Leon-AW/Saugroboter/README.md

# Fachuebergreifendes Projekt: Saugroboter

Unser Projekt verfolgt das Ziel einen automatisierten Staubsauger zu bauen und zu programmieren, welcher selbstständig den Raumboden von Staub oder anderen Partikeln befreit. Durch den Eigenbau soll die Wartung und Reparatur und somit die Instandhaltung erleichtert werden.

## Authoren

1. Leila Oppermann
2. Ala Al-Khazzan
3. Marc Zimmermann
4. Leon Wagner

## Hinweise

### Bedienungsanleitung

Der Saugroboter wird über den weißen Wippschalter auf der Oberseite ein- und ausgeschaltet.
Hinweise vor Inbetriebnahme:
1. Vor dem Einschalten sollte darauf geachtet werden, dass keine Sicherheitsrisiken wie Stufen, Hänge oder Nässe für den Saugroboter zugänglich sind. Ist der Saugroboter in einem trockenen ebenen Raum platziert, so kann er eingeschaltet werden. Der Saugroboter reinigt solange den Boden, bis er ausgeschaltet wird oder der Akkustand niedrig ist. In diesem Fall schaltet er sich selbstständig aus.
2. Vor jedem Einschalten sollte der Schmutzauffangbehälter an der Oberseite des Gehäuses entnommen, geprüft und bei Bedarf geleert werden.

Der Akku wird über die Akkuladestation aufgeladen. Die Akkuladestation wird über normalen Haushaltsstrom 230V betrieben. Sobald es nötig ist, den Akku aufzuladen, leuchtet die rote Kontroll-LED an der Oberseite des Gehäuses. Solange der Saugroboter eingeschaltet ist, leuchtet die grüne Kontroll-LED an der Oberseite des Gehäuses.

Sollte der Saugroboter nicht wie erwartet funktionieren, so können die weiteren Kontroll-Leuchten Auskunft über das Problem geben. Siehe hierzu den Abschnitt "Wartung".

### Wartung

LED Color Code:
- Rot außen an: Akkustand niedrig.
- Grün außen an: Gerät eingeschaltet und mit ausreichend Strom versorgt.
- Grün außen blinkt schnell: Spannung zu niedrig, Akku und Verbindungen prüfen.
- Weiß innen an: Ventilator korrekt angeschlossen.
- Blau innen an: Ventilator Spannung korrekt.
- Gelb innen an: Spannung an der Batterie korrekt.

Der Saugroboter kann ohne Werkzeug geöffnet werden. Elektronik-affine NutzerInnen können anhand der Kontroll-LEDs viele häufige Fehler ausfindig machen und beheben. Alle Bauteile bis auf das Gehäuse können privat unter 30€ nachgekauft werden.
