Leon-AW/Saugroboter/Dokumentation/01-Lastenheft/Lastenheft_Gruppe1.pdf

Lastenheft
Saugroboter

© HTW Berlin

# Lastenheft im

# fachübergreifenden Projekt

## Saugroboter

Teammitglieder: | Leila Oppermann,
| Ala Al-Khazzan,
| Leon Wagner,
| Marc Zimmermann
Professor: | Dr.-Ing. Christian Müller
Produkt: | Saugroboter
Ort, Datum: | Berlin, 26.04.2022

© HTW Berlin | Seite I

### Inhaltsverzeichnis

Tabellenverzeichnis | II
Abbildungsverzeichnis | II

© HTW Berlin | Seite II

### Tabellenverzeichnis

### Abbildungsverzeichnis

© HTW Berlin | Seite 1

### 1 Einleitung

Heutzutage sind Smart Home Geräte, Smartphones und vieles mehr nicht mehr aus unserem Alltag wegzudenken. Der Mikroprozessor nimmt eine dominante Rolle in fast jedem Gerät ein, so ist er auch das Herzstück eines Saugroboters. Zu jedem modernen Haushalt gehört heutzutage auch ein kleiner Helfer, welcher den Raum automatisiert von Staub befreien kann und genau das gilt es hier zu entwickeln.

### 2 Ausgangssituation

Momentan sind Saugroboter teuer und nur für wohlhabende Menschen finanzierbar. Größere Firmen arbeiten täglich daran mit Ihrem Saugroboter den Markt zu dominieren. Dabei geht die Individualisierbarkeit des Saugroboters verloren und der Innenraum und dessen Funktionalität wird unübersichtlich.

### 3 Zielsetzung

Das Ziel des automatisierten Staubsaugers ist es, selbstständig den Raumboden von Staub oder anderen Partikeln zu befreien. Durch den Eigenbau sollen die Wartung und Reparatur und somit die Instandhaltung erleichtert werden. Damit richtet sich das Design des Roboters nach dem aktuell viel diskutierten „Right to Repair“. Des Weiteren stehen die Erarbeitung und Weitergabe von Wissen im Vordergrund. Die Sensorik und die Algorithmen des Saugroboters können von nachfolgenden Gruppen späterer Semester ausgebaut werden. So steht der HTW ein weiteres erweiterbares fachübergreifendes Projekt zur Verfügung. Auch die Entwicklung einer App und Ausstattung mit einem WiFi Modul wäre in der Zukunft denkbar.

### 4 Anforderungen

### 4.1 Funktionale Anforderungen

Alle Anforderungen werden hier mit hoher Priorität betrachtet.

Tabelle 1: Funktionale Anforderungen

Nr. | Gruppe | Beschreibung
FA 1 | Allgemein
FA-1.1 | | Der Saugroboter muss erkennen können, wenn der Ein- und Ausschaltknopf betätigt wird und darauf reagieren.
FA-1.2 | | Bei Erkennung des Anschaltzustandes soll die LED mit der je-weiligen Farbe leuchten.
FA-1.3 | | Der Saugroboter soll über einen Ardunio-Mikrocontroller ge-steuert werden.
FA-1.4 | | Als Energiequelle des Arduinos soll eine Batterie oder ein Akku verwendet werden.
FA 2 | Hinderniserken- nung
FA-2.1 | Die Software soll ermöglichen Hindernisse zu umfahren.
FA-2.2 | Es soll einen Bumpsensor geben, um Hindernisse zu registrie-ren.
FA 3 | Bewegung
FA-3.1 | Die Räder sollen einen Richtungswechsel durchführen können.
FA-3.2 | Der Antrieb der Räder soll über einen Servomotor erzielt wer-den.
FA 4 | Saugmechanismus
FA-4.1 | Zum Auffangen der Schmutzpartikel muss ein Staubbehälter verwendet werden.
FA-4.2 | Ein Ventilator soll die Luft einsaugen.
FA-4.3 | Ein Luftfilter soll die eingesogene Luft ohne Staub aus dem Saugroboter lassen.

### 4.2 Nicht-funktionale Anforderungen

Tabelle 2: Nicht-funktionale Anforderungen

Nr. | Beschreibung | Priorisierung

NA-

1.1 | Der Saugroboter soll in weniger als 30 Minuten einen leeren Raum von 15m² saugen können. | mittel

NA-

1.3 | Der Kunde soll den Saugroboter nach Lesen der read.me bedienen können. | hoch

NA-

1.4 | Der Saugroboter sollte sich nicht von kleinen Hinder- nissen wie bspw. Nüssen o.Ä. stören lassen. | mittel

NA-

1.5 | Durch Wiederaufladen des Akkus soll der Saugrobo- ter wiederverwendet werden können. | hoch

NA-

1.6 | Die Komponenten des Saugroboters lassen sich ohne große Umstände austauschen. | gering

### 4.3 Technische Anforderungen

Alle Anforderungen werden hier wieder mit hoher Priorität betrachtet.

Tabelle 3: Technische Anforderungen

Nr. | Beschreibung
TA-1.1 | Die Software soll in C++ geschrieben sein und ausschließlich in der Arduino-Umge-bung arbeiten können.
TA-1.2 | Zur Entwicklung kann jede beliebige Programmierumgebung verwendet werden – vor-zugsweise Visual Studio oder die Arduino IDE.

### 4.4 Konstruktive Anforderungen

Alle Anforderungen werden hier auch mit hoher Priorität betrachtet.

Tabelle 4: Konstruktive Anforderungen

Nr. | Beschreibung
KA-1.1 | Der Saugroboter soll einen austauschbaren Behälter, zum Leeren der Schmutzpartikel enthalten.
KA-1.2 | Das Gehäuse soll leicht zu öffnen sein, damit der Saugroboter wartungsfreundlich ist.
KA-1.3 | Das Gehäuse soll stabil und robust gegen Unfälle sein, damit die technische Innen- ausstattung sicher bleibt.
KA-1.4 | Der Saugroboter muss über den Standard 230 V Stromnetz versorgt werden.
KA-1.5 | Es wird ein Ein- und Ausschaltknopf benötigt, damit der Motor des Saugroboters star-tet bzw. stoppt.
KA-1.6 | Der Saugroboter soll je nach Zustand (an oder aus), die Signalform anzeigen können (LED).

### 5 Angestrebte Lösungsskizze

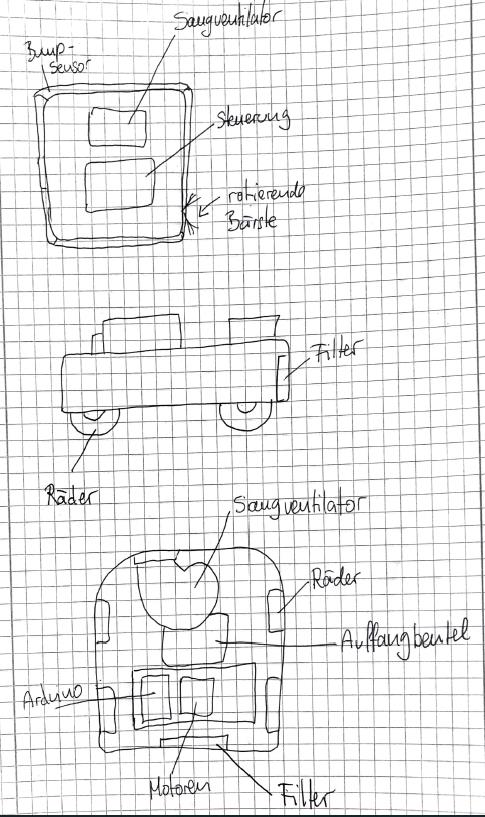
[picture p60: figure]

Abbildung 1: Lösungsskizze

### 6 Abnahmekriterien

1. Alle hoch priorisierten Anforderungen müssen erfüllt sein.
2. Der Saugroboter sollte den Raum auf effizienter Weise von Staub befreien.
3. Das Produkt muss stabil sein und fehlerfrei laufen.

### 7 Ansprechpartner für Rückfragen

Name Leila Oppermann

Ala
Al-Khazzan

Leon
Wagner

Marc
Zimmermann

E-Mail s0573469@htw- berlin.de

s0573997@htwberlin.de

s0575232@htwberlin.de

s0573431@htwberlin.de

### 8 Wer hat was gemacht

Autor | Anteil
Leila | 25 %
Ala | 25 %
Leon | 25 %
Marc | 25 %
