Leon-AW/Saugroboter/Dokumentation/04-Qualitätssicherung/G1_Qualitatssicherung_Gruppe1_S1_CM.pdf

### Qualitätssicherung Saugroboter

© HTW Berlin

# Qualitätssicherung im fachübergreifenden Projekt

# Saugroboter

Teammitglieder: | Leila Oppermann, Ala Al-Khazzan, Leon Wagner, Marc Zimmermann
Betreuer: | Prof. Dr.-Ing. Christian Müller
Produkt: | Saugroboter
Ort, Datum: | Berlin, 14.06.2022

© HTW Berlin

Versionshistorie

Tabelle 1: Versionshistorie

Version | Datum | Verantwortlich | Änderung
1.0 | 14.06.2022 | Gruppe 1 | Version 1

© HTW Berlin | Seite I

## Inhaltsverzeichnis

Tabellenverzeichnis | II
Verzeichnis vorhandener Dokumente | III

© HTW Berlin | Seite II

## Tabellenverzeichnis

Tabelle 2: Verzeichnis vorhandener Dokumente | III

© HTW Berlin | Seite III

## Verzeichnis vorhandener Dokumente

Alle für die vorliegende Spezifikation ergänzenden Unterlagen müssen hier aufgeführt werden

Tabelle 2: Verzeichnis vorhandener Dokumente

Dokument | Autor | Datum
Lastenheft_Gruppe1.pdf | Leila, Ala, Leon, Marc | 26.04.2022
Lastenheft_Gruppe1_CM.pdf (Kommentiert) | Leila, Ala, Leon, Marc + Christian Müller | 05.05.2022
Pflichtenheft_Gruppe1.pdf | Leila, Ala, Leon, Marc | 26.04.2022
Backlog_Gruppe1.xlsx | Leila, Ala, Leon, Marc | 24.05.2022
Projektplan_Gruppe1.mpp (Version 1.0) | Leon | 24.05.2022
G1_Pflichtenheft_Gruppe1_CM.pdf | Leila, Ala, Leon, Marc + Christian Müller | 30.05.2022
Technische Spezifikation (Version 1.0) | Leila, Ala, Leon, Marc | 14.06.2022

© HTW Berlin | Seite 4

## 1 Testfälle 1.1 Testfall 1: Stabilität des Werkstoffs für das Gehäuse

Tabelle 3: Stabilität des Werkstoffs prüfen

Testfall | Beschreibung
Testfall-Nummer | 01
Testart | Funktionstest
Zu testender Geschäftsprozess/ Zu testende Funktionsgruppe | Stabilität vom Werkstoff des Saugroboters

Testziel

Testen, ob der Werkstoff vom Gehäuse aus dem 3D-Drucker, geeignet ist, um auch mit einem Objekt zu kollidieren ohne, dass es danach funktionseinschränkende Schädigungen erfährt.

Testvoraussetzungen | • | Das Gehäuse oder ein Teil davon, muss schon fertig gedruckt sein.

Testfalldaten

1. Es wird überprüft, ob schon beim 3D-Druck Teile vom Gehäuse Mängel aufweisen.
2. Das Gehäuse wird mit der Stirnseite auf ein bewegungsfähiges Konstrukt draufgelegt und mit mäßiger Geschwindigkeit z.B. gegen einen Stuhl gefahren.
Erwartetes Verhalten | Das Gehäuse bleibt nach dem Aufprall stabil und ist nicht kaputt.

Tabelle 4: Auswertung - Testfall 1

Testergebnis | X Bestanden □ Nicht bestanden
Fehlerkategorie | X Leicht □ Mittel □ Schwerwiegend
Bemerkung | -
Datum | 14.06.2022

## 1.2 Testfall 2: Korrekte Bauteilabmessungen

Tabelle 5: Korrekte Bauteilabmessungen

Testfall | Beschreibung
Testfall-Nummer | 02
Testart | Funktionstest
Zu testender Geschäftsprozess/ Zu testende Funktionsgruppe | Bauteilabmessungen auf Korrektheit prüfen
Testziel | Überprüfen, ob die Abmessungen der Gehäusebauteile mit den Ab-messungen den 2D-Skizzen der Bauteile übereinstimmen.
Testvoraussetzungen | • 2D-Skizze wurden erstellt • Maßband und Schiebemesser vorhanden
Testfalldaten | Abmessungen der einzelnen Bauteile und der 2D-Skizzen der jeweili- gen Bauteile
Erwartetes Verhalten | Maße stimmen überein

Tabelle 6: Auswertung - Testfall 2

Testergebnis | X Bestanden | □ Nicht bestanden
Fehlerkategorie | □ Leicht | □ Mittel | X Schwerwiegend
Bemerkung | -
Datum | 14.06.2022

## 1.3 Testfall 3: Vorhanden sein aller Bauteile

Tabelle 7: Vorhanden sein aller Bauteile

Testfall | Beschreibung
Testfall-Nummer | 03
Testart | Funktionstest

Zu testender Geschäftsprozess/
Zu testende Funktionsgruppe | Sind alle benötigen Bauteile vorhanden
Testziel | Sicherstellen, dass alle Bauteile für das Endprodukt zu dem Zeitpunkt vorhanden sind.
Testvoraussetzungen | • Die Recherche, welche Bauteile bestellt und eingekauft wer-den müssen, wurde erledigt.
Testfalldaten | Es wird eine Checkliste für die Bauteile abgearbeitet. Falls das Bau-teil vorhanden ist, wird dieses abgehakt, ansonsten bekommt dieses ein „x“.
Erwartetes Verhalten | Problemloses zusammenbauen

Tabelle 8: Auswertung - Testfall 3

Testergebnis | X Bestanden | □ Nicht bestanden
Fehlerkategorie | □ Leicht □ Mittel X Schwerwiegend
Bemerkung | -
Datum | 14.06.2022

## 1.4 Testfall 4: Montierbarkeit des Gehäuses

Tabelle 9: Montierbarkeit des Gehäuses

Testfall | Beschreibung
Testfall-Nummer | 04
Testart | Funktionstest

Zu testender Geschäftsprozess/
Zu testende Funktionsgruppe | Montierbarkeit des Gehäuses überprüfen
Testziel | Validieren, ob die Einzelbauteile des Saugroboters ohne Komplikatio- nen zusammengebaut werden können.

Testvoraussetzungen

- Alle benötigen Bauteile vorhanden
- Zusätzliche Werkzeuge wie z.B. Schraubenzieher, Zange oder Lötkolben
Testfalldaten | Zusammenbau der einzelnen Teile zum Gesamtprodukt
Erwartetes Verhalten | Problemloses zusammenbauen des Gehäuses

Tabelle 10: Auswertung - Testfall 4

Testergebnis | X Bestanden | □ Nicht bestanden
Fehlerkategorie | □ Leicht | □ Mittel | X Schwerwiegend
Bemerkung | -
Datum | 14.06.2022

## 1.5 Testfall 5: Erfüllen die Komponenten ihre Funktion erfüllt

Tabelle 11: Erfüllen die Komponenten ihre Funktion erfüllt

Testfall | Beschreibung
Testfall-Nummer | 05
Testart | Funktionstest
Zu testender Geschäftsprozess/ Zu testende Funktionsgruppe | Funktionalität der Komponenten
Testziel | Überprüfen, ob der Saugroboter nach dem Zusammenbau der einzel-nen Komponenten stabil ist und, durch Muskelkraft angetrieben, fahren kann.
Testvoraussetzungen | • Saugroboterbauteile montiert
Testfalldaten | Manuelle Bewegungen des Saugroboters in alle Richtungen
Erwartetes Verhalten | Saugroboter fährt dementsprechend und bleibt in der Ausgangsform erhalten

Tabelle 12: Auswertung - Testfall 5

Testergebnis | X Bestanden | □ Nicht bestanden
Fehlerkategorie | □ Leicht X Mittel □ Schwerwiegend
Bemerkung | -
Datum | 14.06.2022

## 2 Testprotokoll

Tabelle 13: Testprotokoll

Testfall-Nr.

| Datum | Status
01 | 14.06.2022 | bestanden
02 | 14.06.2022 | bestanden
03 | 14.06.2022 | bestanden
04 | 14.06.2022 | bestanden
05 | 14.06.2022 | bestanden

## Anhang

## A Fehlerkategorien

Für die Abnahme des Systems sind folgende Fehlerklassen definiert:

- 3 = Schwerwiegender Mangel Produktivsetzung nicht möglich (nachhaltige Störung des Softwareablaufes mit daraus resultierender Funktionsuntüchtigkeit des Systems bzw. Störung von Systemteilen, die zur Störung aller Arbeitsabläufe beim Auftraggeber führt.)
- 2 = Mittlerer Mangel | Produktivsetzung möglich, aber mangelhafte Funktionen nicht nutzbar (durch eine Störung treten in Teilen der Programmabläufe erhebliche Störungen auf, sodass Teile der Software nicht verwendbar sind.)
- 1 = Leichter Mangel | Produktivsetzung durch Workaround mit vertretbarem Zusatzaufwand möglich (alle anderen als die in den vorstehenden Prioritätsgraden be- schriebenen Störungsbilder)

## B Qualitätskriterien nach ISO 9126

Gruppe | Q-Kriterium
| Angemessen-heit | Merkmale von Software, die sich auf das Vorhandensein und die Eignung einer Menge von Funktionen für spezifizierte Aufgaben beziehen.
| Richtigkeit | Merkmale von Software, die sich beziehen auf das Liefern der richtigen oder vereinbarten Ergebnisse oder Wirkungen.
| Inter-operabilität | Merkmale von Software, die sich auf ihre Eignung beziehen, mit vorgegebenen Systemen zusammenzuwirken.
| Ordnungs-mäßigkeit | Merkmale von Software, die bewirken, dass die Software anwendungsspezifische Normen oder Vereinbarungen oder gesetzliche Bestimmungen oder ähnliche Vorschriften erfüllt.
| Sicherheit | Merkmale von Software, die sich auf ihre Eignung beziehen, unberechtigten Zu-griff, sowohl versehentlich als auch vorsätzlich, auf Programme und Daten zu verhindern.
| Reife | Merkmale von Software, die sich auf die Häufigkeit von Versagen durch Fehlzu-stände in der Software beziehen.
| Fehler-toleranz | Merkmale von Software, die sich auf ihre Eignung beziehen, ein spezifiziertes Leistungsniveau bei Software-Fehlern oder Nicht-Einhaltung ihrer spezifizierten Schnittstelle zu bewahren.
| Wieder-herstellbarkeit | Merkmale von Software, die sich beziehen auf die Möglichkeit, bei einem Versa-gen ihr Leistungsniveau wiederherzustellen und die direkt betroffenen Daten wiederzugewinnen, und auf die dafür benötigte Zeit und den benötigten Aufwand.
| Verständ-lichkeit | Merkmale von Software, die sich auf den Aufwand für den Benutzer beziehen, das Konzept und die Anwendung zu verstehen.
| Erlernbarkeit | Merkmale von Software, die sich auf den Aufwand für den Benutzer beziehen, ihre Anwendung zu erlernen. (z.B. Ablaufsteuerung, Eingabe, Ausgabe)
| Bedienbarkeit | Merkmale von Software, die sich auf den Aufwand für den Benutzer bei der Be-dienung und Ablaufsteuerung beziehen.
| Zeitverhalten | Merkmale von Software, die sich beziehen auf die Antwort- und Verarbeitungszei-ten und auf den Durchsatz bei der Ausführung ihrer Funktionen.
| Verbrauchs-verhalten | Merkmale von Software, die sich darauf beziehen, wie viele Betriebsmittel bei der Erfüllung ihrer Funktionen benötigt werden und wie lange.
| Analysier-barkeit | Merkmale von Software, die sich auf den Aufwand beziehen, der notwendig ist, um Mängel oder Ursachen von Versagen zu diagnostizieren oder um änderungs-bedürftige Teile zu bestimmen.
| Modifizier-barkeit | Merkmale von Software, die sich auf den Aufwand beziehen, der zur Ausführung von Verbesserungen, zur Fehlerbeseitigung oder zur Anpassung an Umgebungs-änderungen notwendig ist.
| Stabilität | Merkmale von Software, die sich auf das Risiko unerwarteter Wirkungen von Änderungen beziehen.
| Prüfbarkeit | Merkmale von Software, die sich auf den Aufwand beziehen, der zur Prüfung der geänderten Software notwendig ist.
| Anpass-barkeit | Merkmale von Software, die sich auf die Möglichkeit beziehen, sie an verschiede-ne festgelegte Umgebungen anzupassen, wenn nur Schritte unternommen oder Mittel eingesetzt werden, die für diesen Zweck für die betrachtete Software vorge-sehen sind.
| Installier-barkeit | Merkmale von Software, die sich auf den Aufwand beziehen, der zur Installation der Software in einer festgelegten Umgebung notwendig ist.
| Konformität | Merkmale von Software, die bewirken, dass die Software Normen oder Vereinba-rungen zur Übertragbarkeit erfüllt.
| Austausch-barkeit | Merkmale von Software, die sich beziehen auf die Möglichkeit, diese anstelle einer anderen Software in der Umgebung jener Software zu verwenden und auf den dafür notwendigen Aufwand.

Funktionalität
Sind alle im Pflichtenheft aufgeführten Kriterien vorhanden und ausführbar?

Zuverlässigkeit
Zu welchem Grad erfüllt die Software dauerhaft und
korrekt die geforderten
Funktionen?

Benutzbarkeit
Wie schnell kann man den
Umgang mit der Software
lernen und wie leicht ist sie zu bedienen?

Effizienz
Wie sind zeitliches Verhalten und Ressourcenverbrauch bei gegebenen
Systemvoraussetzungen?

Änderbarkeit

Mit welchem Zeit- und
Arbeitsaufwand lassen sich Änderungen sowie Fehlererkennung und -behebung
durchführen?

Übertragbarkeit

Mit welchem Aufwand lässt
sich die Software an geänderte/ verbesserte Systembedingungen anpassen
bzw. in neuen Systemen
einsetzen?

## C Qualitätskriterien für Dokumente

Für die Erreichung des Projektzieles, das Produkt „Dokument“ zu erzeugen, dass den fachlichen und technischen Anforderungen des Auftraggebers entspricht, ergeben sich z.B. die folgenden Qualitätsmerkmale:

Merkmal | Erläuterung | Mindest- anfordrg.

Prüfmöglichkeit

Eindeutigkeit | Eignung von Dokumenten zur un-missverständlichen Vermittlung von Informationen für jeden Leser | | Keine offenen Fragen zu den einzelnen Abschnitten (Prüfung durch Gruppeninspek-tion und Diskussion)
Lesbarkeit | Eignung von Dokumenten zur Ent-nahme der darin enthaltenen Infor-mationen | ja | Prüfung durch Einsatz eines unbedarften Testlesers, Vorhandensein eines Glossars, Erläuterung von Fachbegriffen
Verständlichkeit | Eignung von Dokumenten zur erfolg-reichen Vermittlung der darin enthal-tenen Informationen an einen sach-kundigen Leser | ja | Vorhandensein eines Glossars, Integration von Illustrationen, Diagrammen
Detaillierungsgrad | Vorhandensein der ausreichenden Beschreibung der fachlichen und technischen Einzelheiten im Doku-ment | | Beschreibung der Sonder- und Ausnahme-fälle, gleiche Behandlung (gleiche Detaillie-rung) aller Textabschnitte
Funktionale Vollständigkeit | Vorhandensein der für den Zweck der Dokumentation notwendigen und hinreichenden Information | ja | Einsatz des <KUNDE>Templates gewähr-leistet die Vollständigkeit an notwendigen Informationen, Beschreibung der Sonder-und Ausnahmefälle
Fehlerfreiheit | Nichtvorhandensein von sprachli-chen Fehlern, die die Informations-aufnahme beeinträchtigen | | Rechtschreib- und Grammatikprüfung
Widerspruchsfreiheit | Nichtvorhandensein von einander entgegenstehenden Aussagen im Dokument | | Unnötige Redundanzen sollen vermieden werden, Dokument soll in sich konsistent sein
Aktualität | Übereinstimmung der Beschreibung der Situation in Dokument und Wirk-lichkeit | | Gespräche mit dem Auftraggeber (Kun-deninspektion, Workshops)
Funktionale Korrektheit | Nichtvorhandensein von funktionalen Fehlern, die den fachlichen und technischen Inhalt betreffen | ja | Wiedergabe der Anforderungen aus dem Vorgängerdokument
Normenkonformität | Erfüllung der für die Erstellung von Dokumenten geltenden Vorschriften und Normen | | Einsatz des <KUNDE>Templates gewähr-leistet die formale Richtigkeit
Änderbarkeit | Eignung von Dokumenten zur Ermitt-lung aller von einer Änderung be-troffenen Dokumententeile und zur Durchführung der Änderung | | Einsatz des <KUNDE>Templates gewähr-leistet die formale Änderbarkeit, unnötige Redundanzen sollen vermieden werden
